djaenicke/oscar_design/matlab/fxos_calibration/motionCalresults.JPG

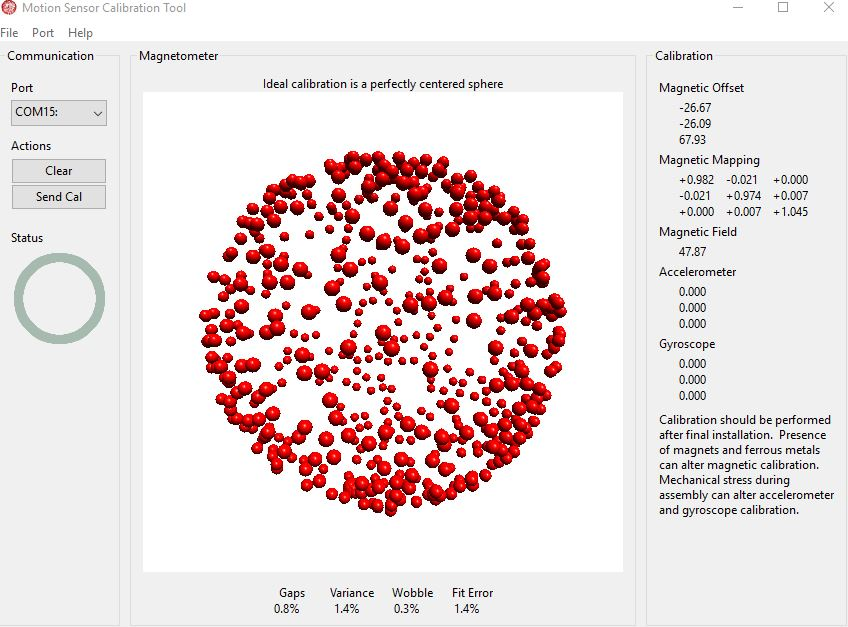
matlab/fxos_calibration/motionCalresults.JPG
