djaenicke/oscar_design/README.md

# robo_car
Robot car platform used for developing autonomous vehicle concepts
