djaenicke/oscar_design/(list of files, cad)

Other CAD files:
mechanical/v2/assembly_v2.dwg
mechanical/v2/OldVersions/assembly_v2.0004.dwg
mechanical/assembly_v2.iam
mechanical/battery_pack_clamp_v2.ipt
mechanical/bp_v3.ipt
mechanical/gearmotor.ipt
mechanical/main_motor_mount.ipt
mechanical/mock_wheel.ipt
mechanical/motor_support_v2.ipt
mechanical/rplidar_adapter_board_holder.ipt
mechanical/tenergy_nimh_2200.ipt
mechanical/tp_v2.ipt
mechanical/v1/base_plate_bottom.ipt
mechanical/v1/base_plate_no_holes.ipt
mechanical/v2/anker_battery_pack.ipt
mechanical/v2/assembly.iam
mechanical/v2/battery_pack_clamp.ipt
mechanical/v2/boost_converter.ipt
mechanical/v2/bp_v2.ipt
mechanical/v2/gearmotor.ipt
mechanical/v2/mock_wheel.ipt
mechanical/v2/motor_support.ipt
mechanical/v2/tp_v2.ipt
mechanical/v2/wheel_axle.ipt
