djaenicke/oscar_design/electrical/oscar_shield.pdf

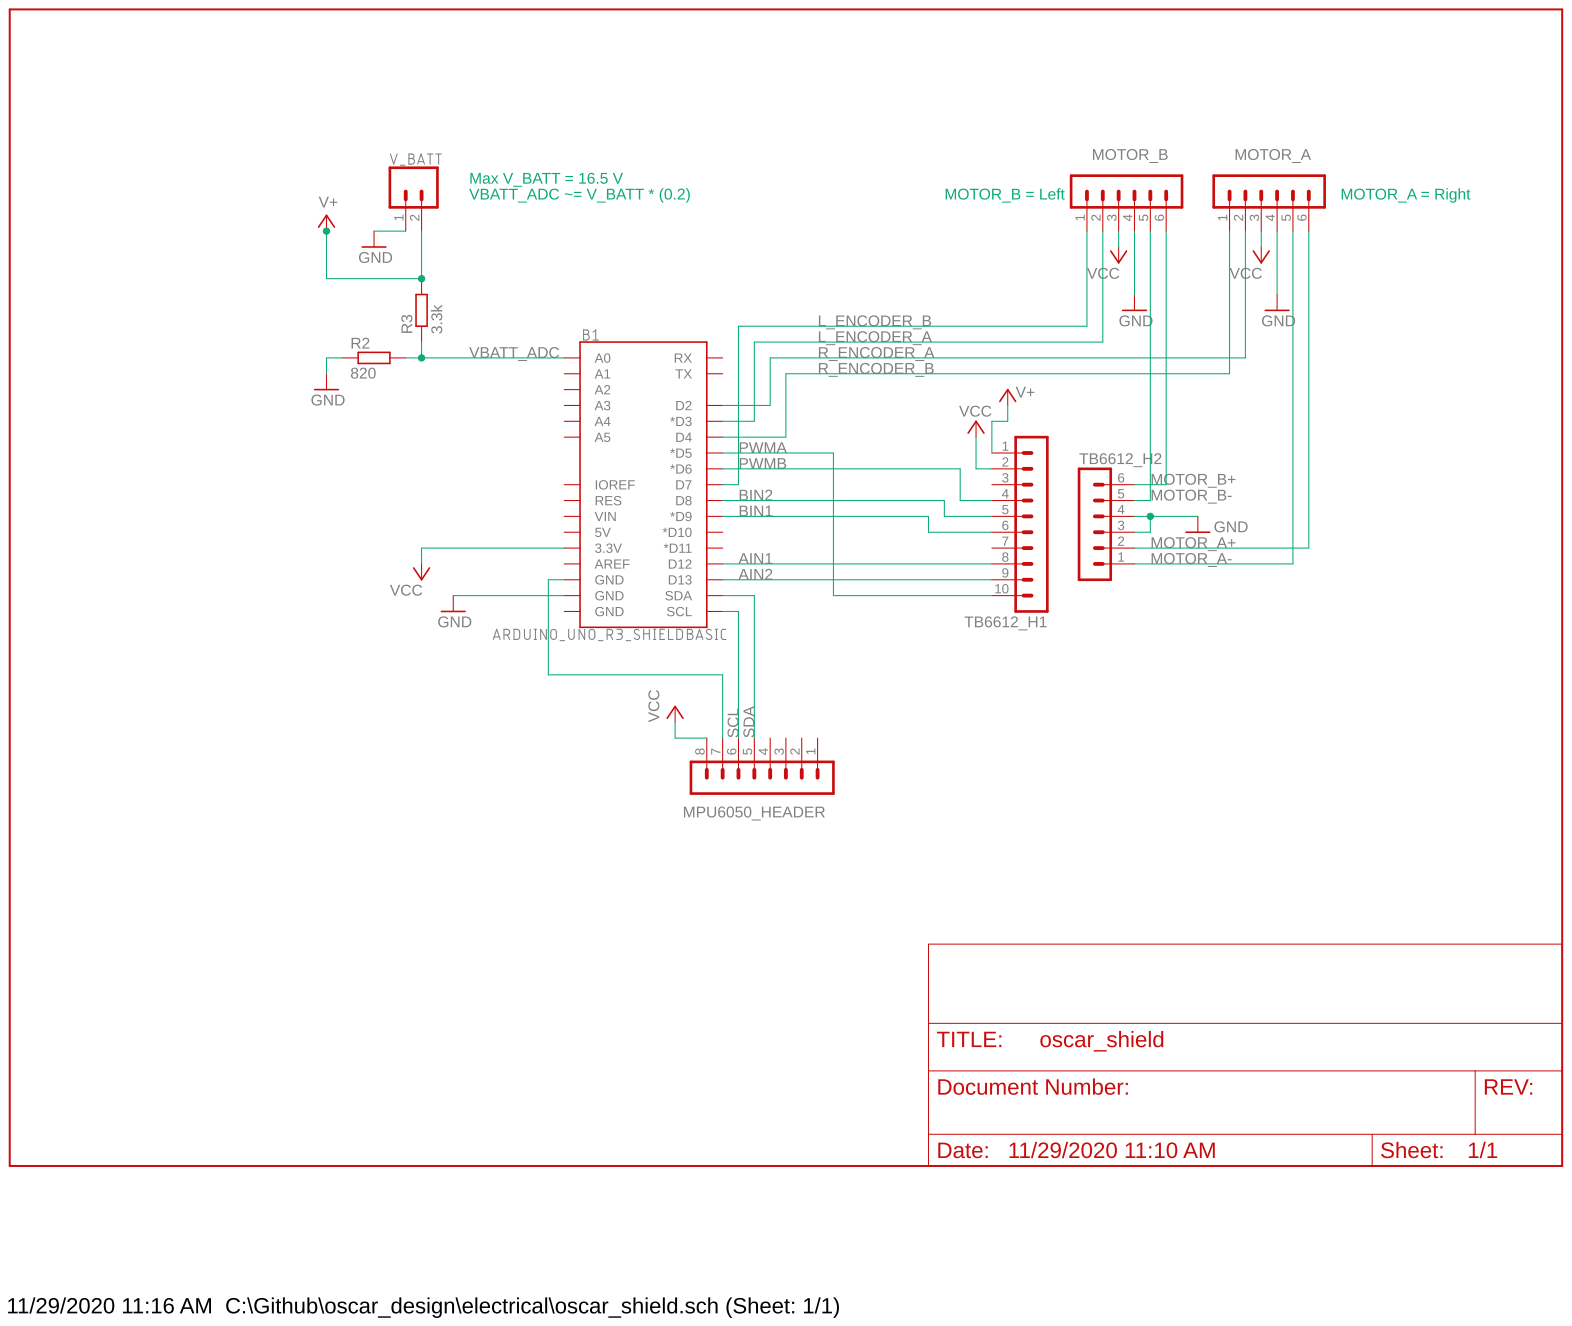
[picture p2: page 1]
