djaenicke/oscar_design/electrical/v1/robo_shield.brd

## EAGLE design electrical/v1/robo_shield.brd (2020-05-10)

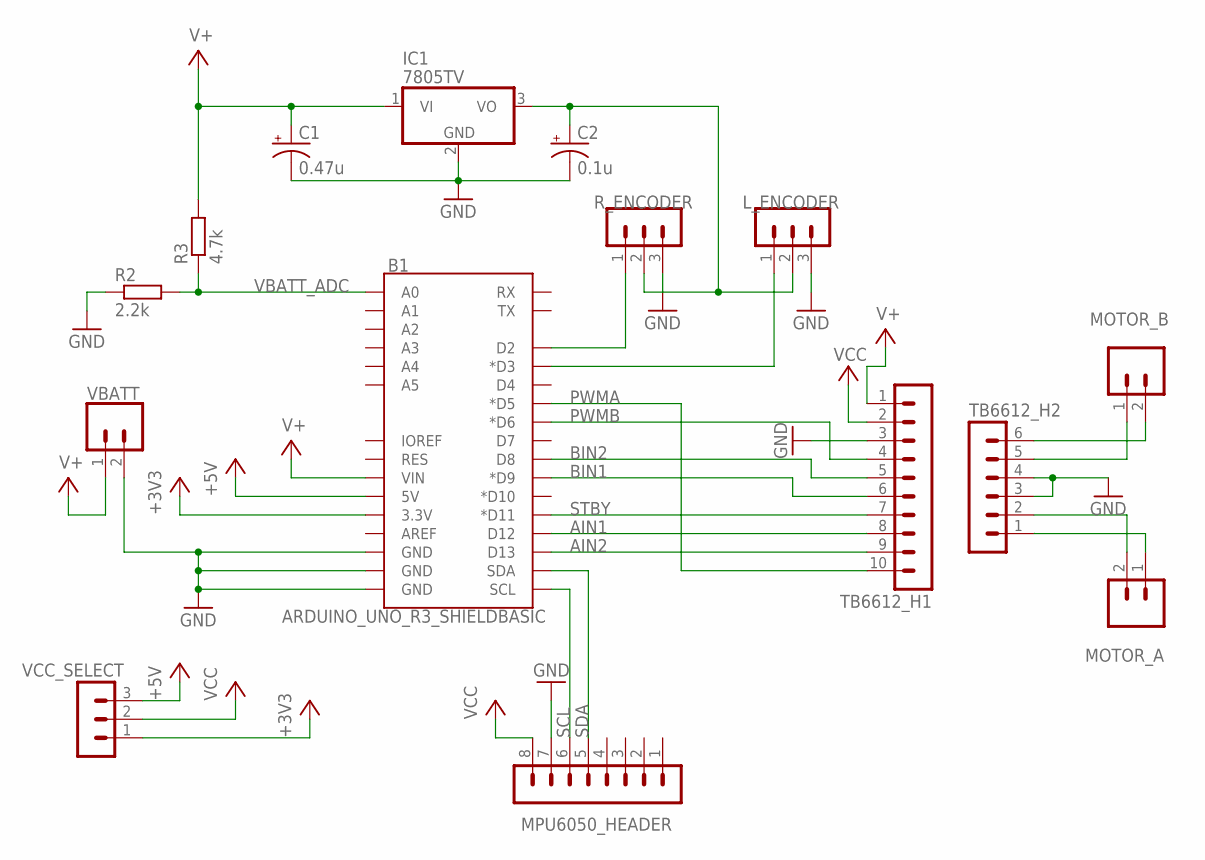
[picture p3: schematic robo_shield.sch]

Parts:
B1: ARDUINO_UNO_R3_SHIELDBASIC; UNO_R3_SHIELD
C1: 0.47u; E5-5
C2: 0.1u; E5-5
IC1: 7805TV; TO220V
L_ENCODER: MA03-1
MOTOR_A: CONN_025MM; SCREWTERMINAL-5MM-2
MOTOR_B: CONN_025MM; SCREWTERMINAL-5MM-2
MPU6050_HEADER: MA08-1
R2: 2.2k; 0207/10
R3: 4.7k; 0207/10
R_ENCODER: MA03-1
TB6612_H1: MA10-1
TB6612_H2: MA06-1
VBATT: CONN_025MM; SCREWTERMINAL-5MM-2
VCC_SELECT: MA03-1

Connections:
+3V3: B1.3.3V, VCC_SELECT.1
+5V: B1.5V, VCC_SELECT.3
AIN1: B1.D12, TB6612_H1.8
AIN2: B1.D13, TB6612_H1.9
BIN1: B1.D9 (*D9), TB6612_H1.6
BIN2: B1.D8, TB6612_H1.5
GND: B1.GND@0 (GND), B1.GND@1 (GND), B1.GND@2 (GND), C1.-, C2.-, IC1.2 (GND), L_ENCODER.3, MPU6050_HEADER.7, R2.1, R_ENCODER.3, TB6612_H1.3, TB6612_H2.3, TB6612_H2.4, VBATT.2
unnamed: B1.D2, R_ENCODER.1
unnamed: B1.D3 (*D3), L_ENCODER.1
unnamed: MOTOR_B.2, TB6612_H2.6
unnamed: MOTOR_B.1, TB6612_H2.5
unnamed: MOTOR_A.2, TB6612_H2.2
unnamed: MOTOR_A.1, TB6612_H2.1
unnamed: C2.+, IC1.3 (VO), L_ENCODER.2, R_ENCODER.2
PWMA: B1.D5 (*D5), TB6612_H1.10
PWMB: B1.D6 (*D6), TB6612_H1.4
SCL: B1.SCL, MPU6050_HEADER.6
SDA: B1.SDA, MPU6050_HEADER.5
STBY: B1.D11 (*D11), TB6612_H1.7
V+: B1.VIN, C1.+, IC1.1 (VI), R3.2, TB6612_H1.1, VBATT.1
VBATT_ADC: B1.A0, R2.2, R3.1
VCC: MPU6050_HEADER.8, TB6612_H1.2, VCC_SELECT.2

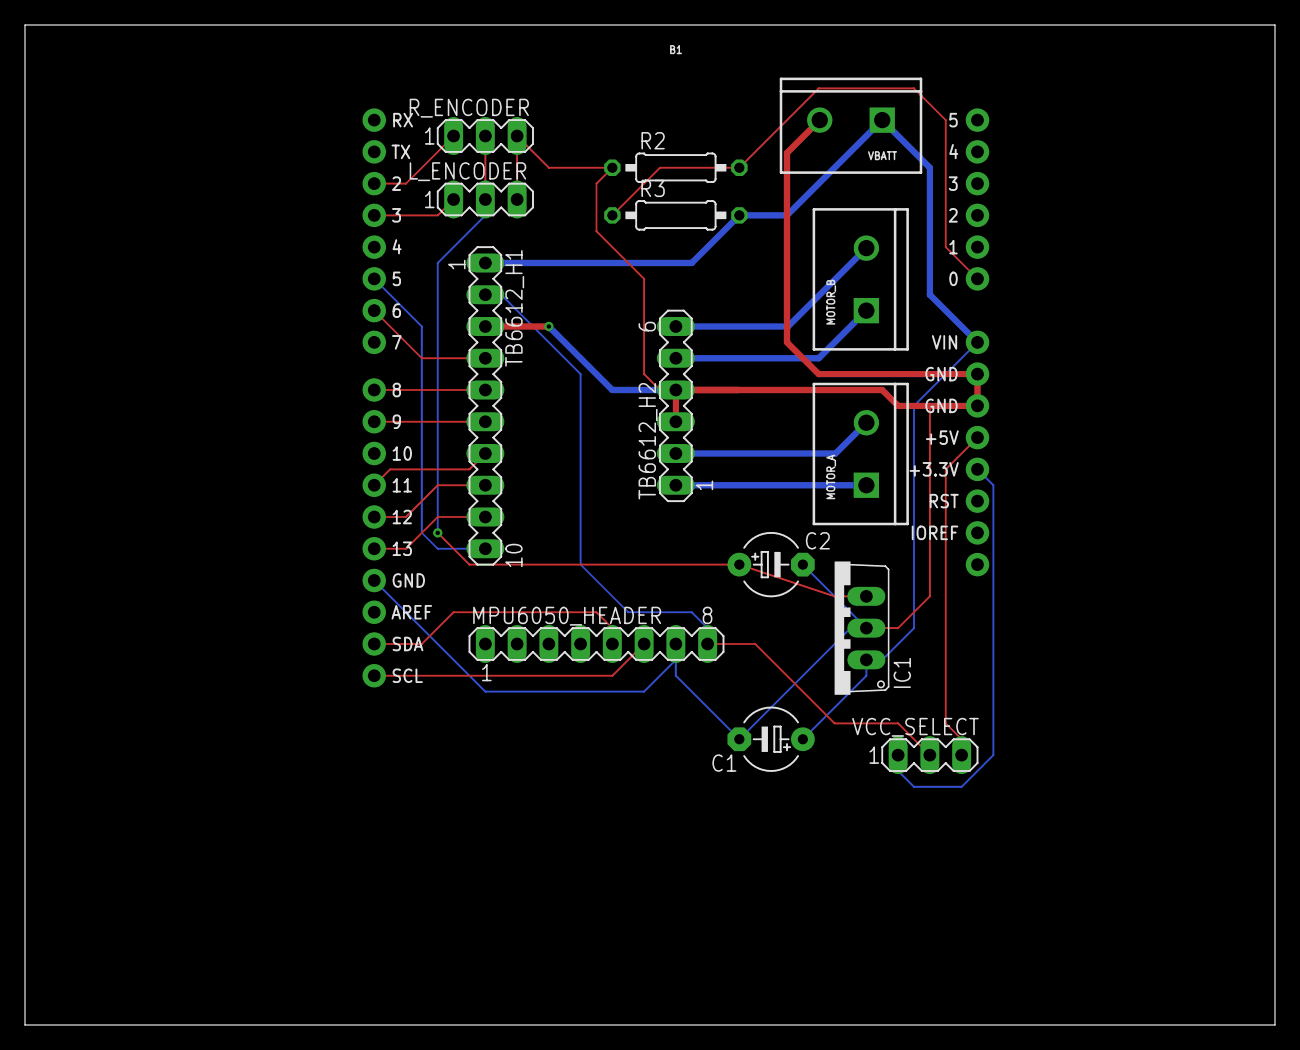
[picture p4: board robo_shield.brd from above]

Board: 2 copper layers, 100.0 x 80.0 mm, 15 parts (0 on the bottom side), 22 nets.
