djaenicke/oscar_design/matlab/fxos_calibration/fxos_ss_data.xlsx

ax | ay | az | ax sigma^2 | ay sigma^2 | az sigma^2
0.00719 | 0.00479 | 9.82437 | 2.717815775e-05 | 4.625843339e-05 | 5.244364491e-05
0.0024 | 0.00479 | 9.82677
0.0024 | 0.00958 | 9.84114
-0.00479 | 0.0024 | 9.82677
0 | 0.00479 | 9.82437
0.00479 | -0.00719 | 9.81958
0.00479 | -0.0024 | 9.82677
0.0024 | 0.00479 | 9.81719
-0.00958 | 0.01677 | 9.8124
0 | 0.01198 | 9.81479
0 | 0.01677 | 9.82677
0.00719 | -0.00479 | 9.8124
0 | -0.00958 | 9.82437
-0.0024 | 0.00479 | 9.81958
0.0024 | -0.0024 | 9.82916
0.00719 | 0 | 9.82198
-0.00479 | 0.0024 | 9.82198
0 | -0.00479 | 9.81719
-0.00479 | -0.0024 | 9.81479
0.01198 | 0.00958 | 9.83395
0 | 0 | 9.82198
0.00479 | 0.00958 | 9.83874
0 | 0 | 9.82916
0 | -0.00479 | 9.81719
0.00479 | 0.00719 | 9.82198
0.01198 | -0.00479 | 9.81
0 | 0.0024 | 9.82437
0.0024 | 0.0024 | 9.83395
0 | 0.00479 | 9.81958
-0.00958 | 0 | 9.82677
0.00479 | 0.00479 | 9.82198
-0.0024 | 0.01198 | 9.81479
0.00958 | 0 | 9.81719
-0.00479 | 0.0024 | 9.81958
0.00719 | -0.01198 | 9.81958
-0.0024 | 0.01437 | 9.81479
0.00479 | 0 | 9.81479
-0.00479 | -0.00958 | 9.82916
0.0024 | 0.00958 | 9.81958
0.0024 | 0 | 9.82198
0.00479 | 0.01198 | 9.81719
-0.00719 | -0.01198 | 9.82677
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
