djaenicke/oscar_design/matlab/mpu_calibration/mpu_accel_ss_data.xlsx

ax | ay | az | ax sigma^2 | ay sigma^2 | az sigma^2
-0.05868 | 0.02635 | 9.79803 | 0.000191915692 | 0.0002072919279 | 0.0003625467252
-0.03593 | 0.03712 | 9.82796
-0.05748 | 0.04551 | 9.80521
-0.05628 | 0.05748 | 9.83395
-0.06107 | 0.06227 | 9.82078
-0.04431 | 0.06706 | 9.78366
-0.04551 | 0.05389 | 9.80042
-0.05748 | 0.02275 | 9.82677
-0.04431 | 0.02515 | 9.79084
-0.04311 | 0.03473 | 9.78725
-0.07664 | 0.01437 | 9.77168
-0.03832 | 0.03952 | 9.82796
-0.04191 | 0.04191 | 9.78725
-0.02754 | 0.02635 | 9.78126
-0.05628 | 0.07065 | 9.81838
-0.06347 | 0.05389 | 9.78725
-0.03593 | 0.05628 | 9.78605
-0.06347 | 0.05389 | 9.80641
-0.06347 | 0.0479 | 9.81838
-0.05988 | 0.02515 | 9.80042
-0.03353 | 0.03712 | 9.82198
-0.04551 | 0.03473 | 9.82557
-0.04311 | 0.02754 | 9.81599
-0.04551 | 0.06706 | 9.83515
-0.04072 | 0.06706 | 9.81838
-0.04311 | 0.03832 | 9.81599
-0.06347 | 0.00719 | 9.82677
-0.05509 | 0.04072 | 9.80401
-0.05509 | 0.07065 | 9.80521
-0.03952 | 0.03473 | 9.82677
-0.05509 | 0.02395 | 9.82078
-0.06826 | 0.07904 | 9.76689
-0.06227 | 0.03473 | 9.80641
-0.05149 | 0.03114 | 9.8124
-0.03114 | 0.05988 | 9.82916
-0.05509 | 0.03712 | 9.78725
-0.05748 | 0.01916 | 9.81359
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
