djaenicke/oscar_design/matlab/mpu_calibration/mpu_gyro_ss_data.xlsx

gx | gy | gz | gx sigma^2 | gy sigma^2 | gz sigma^2
-0.00053 | 0.00053 | -0.0008 | 9.995696717e-07 | 6.520316624e-06 | 2.956457156e-05
-0.00053 | 0.00093 | 0.0004
0.00027 | 0.00013 | -0.00133
-0.0004 | 0.00053 | -0.00093
-0.00146 | -0.00013 | -0.00053
-0.00133 | 0.0004 | -0.00067
-0.00053 | -0.00027 | -0.00027
-0.00133 | -0.00013 | -0.00067
-0.00067 | 0.00013 | -0.00093
-0.00133 | 0.0012 | 0.00013
0 | 0.00013 | -0.0012
-0.00146 | 0.00053 | -0.00013
-0.00067 | 0.00053 | 0.0004
-0.0004 | 0.00027 | -0.00067
0 | -0.00013 | -0.0012
-0.00053 | 0.00067 | -0.0004
-0.00067 | -0.00013 | 0.00107
-0.0004 | -0.00013 | 0.00013
-0.0016 | 0.00067 | 0.00053
-0.0004 | -0.00013 | -0.0004
-0.00053 | 0.0012 | -0.00053
-0.00027 | 0.00107 | 0.0004
-0.0008 | 0.00053 | -0.0012
0.0004 | 0.00053 | -0.00053
-0.0004 | -0.0008 | -0.00067
-0.00186 | 0.00133 | -0.00027
-0.0008 | 0.00013 | 0
-0.00107 | 0.0004 | 0.00013
-0.00053 | 0.0008 | 0.00053
0.00013 | 0.00053 | -0.00013
-0.0008 | 0.0004 | -0.00013
-0.00133 | 0.00133 | -0.0008
-0.00186 | 0.00027 | -0.00013
-0.0016 | 0 | 0.0004
-0.00107 | 0.00107 | -0.00013
0.00013 | 0.0008 | 0
-0.00107 | 0.0008 | 0.0004
-0.00173 | 0.00053 | -0.0004
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
