djaenicke/oscar_design/car_controller/source/car_controller.cpp

/*
 * Copyright 2016-2018 NXP
 * All rights reserved.
 *
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
 * o Neither the name of NXP Semiconductor, Inc. nor the names of its
 *   contributors may be used to endorse or promote products derived from this
 *   software without specific prior written permission.
 *
 * THIS SOFTWARE IS PROVIDED BY THE COPYRIGHT HOLDERS AND CONTRIBUTORS "AS IS" AND
 * ANY EXPRESS OR IMPLIED WARRANTIES, INCLUDING, BUT NOT LIMITED TO, THE IMPLIED
 * WARRANTIES OF MERCHANTABILITY AND FITNESS FOR A PARTICULAR PURPOSE ARE
 * DISCLAIMED. IN NO EVENT SHALL THE COPYRIGHT HOLDER OR CONTRIBUTORS BE LIABLE FOR
 * ANY DIRECT, INDIRECT, INCIDENTAL, SPECIAL, EXEMPLARY, OR CONSEQUENTIAL DAMAGES
 * (INCLUDING, BUT NOT LIMITED TO, PROCUREMENT OF SUBSTITUTE GOODS OR SERVICES;
 * LOSS OF USE, DATA, OR PROFITS; OR BUSINESS INTERRUPTION) HOWEVER CAUSED AND ON
 * ANY THEORY OF LIABILITY, WHETHER IN CONTRACT, STRICT LIABILITY, OR TORT
 * (INCLUDING NEGLIGENCE OR OTHERWISE) ARISING IN ANY WAY OUT OF THE USE OF THIS
 * SOFTWARE, EVEN IF ADVISED OF THE POSSIBILITY OF SUCH DAMAGE.
 */
 
/**
 * @file    car_controller.cpp
 * @brief   Application entry point.
 */
#include <stdio.h>

/* SDK includes */
#include "board.h"
#include "peripherals.h"
#include "pin_mux.h"
#include "clock_config.h"
#include "MK64F12.h"
#include "fsl_debug_console.h"
#include "fsl_sysmpu.h"

/* FreeRTOS kernel includes. */
#include "FreeRTOS.h"
#include "task.h"
#include "queue.h"
#include "timers.h"

/* Application */
#include "data_logger.h"
#include "inertial_states.h"
#include "car_controller.h"
#include "io_abstraction.h"
#include "motor_controls.h"
#include "servo.h"
#include "wheel_speeds.h"
#include "bluetooth_control.h"
#include "battery_monitor.h"
#include "interrupt_prios.h"
#include "logging_streams.h"
#include "object_detection.h"

/*******************************************************************************
 * Definitions
 ******************************************************************************/
#define SD_CARD_INIT_TASK_PRIO     (configMAX_PRIORITIES - 1U)
#define MC_DATA_LOGGING_TASK_PRIO  (configMAX_PRIORITIES - 2U)
#define MOTOR_CONTROLS_TASK_PRIO   (configMAX_PRIORITIES - 3U)
#define OBJECT_DETECTION_TASK_PRIO (configMAX_PRIORITIES - 4U)
#define BLUETOOTH_CMD_TASK_PRIO    (configMAX_PRIORITIES - 5U)

typedef struct Task_Cfg_Tag
{
    TaskFunction_t func;
    const char name[configMAX_TASK_NAME_LEN];
    const configSTACK_DEPTH_TYPE stack_size;
    UBaseType_t priority;
    TaskHandle_t handle;
} Task_Cfg_T;

static void Init_App(void);

/*******************************************************************************
* Variables
******************************************************************************/


/*******************************************************************************
 * Function Definitions
 ******************************************************************************/
int main(void)
{
   /* Init board hardware. */
   BOARD_InitBootPins();
   BOARD_InitBootClocks();
   BOARD_InitBootPeripherals();

   /* Init FSL debug console. */
   BOARD_InitDebugConsole();
   NVIC_SetPriority(BOARD_SDHC_IRQ, SDHC_INT_PRIO);
   SYSMPU_Enable(SYSMPU, false);

   Init_App();
   Set_GPIO(BLUE_LED, LOW);

   /* Create OS Tasks */
   xTaskCreate(Motor_Controls_Task,  "Motor_Controls",    1024, NULL, MOTOR_CONTROLS_TASK_PRIO,   NULL);
   xTaskCreate(Bluetooth_Cmd_Task,   "Bluetooth_Control", 1024, NULL, BLUETOOTH_CMD_TASK_PRIO,    NULL);
   xTaskCreate(SD_Card_Init_Task,    "SD_Card_Init_Task", 1024, NULL, SD_CARD_INIT_TASK_PRIO,     NULL);
   xTaskCreate(Log_MC_Stream_Task,   "MC_Logging_Task",   1024, NULL, MC_DATA_LOGGING_TASK_PRIO,  NULL);
   xTaskCreate(Object_Detection_Task,"Obj_Det_Task",      1024, NULL, OBJECT_DETECTION_TASK_PRIO, NULL);

   vTaskStartScheduler();
}

void Init_App(void)
{
   Init_Battery_Monitor();
   Init_Inertial_Sensors();
   Init_Wheel_Speed_Sensors();
   Init_Motor_Controls();
   Init_Object_Detection();
   Bluetooth_Serial_Open();
   Create_Streams();

   NVIC_SetPriorityGrouping(0U);
}
