djaenicke/oscar_design/(commit log)

2019-06-07 Updated core clock to 120 MHz
    Also, the default board files were replaced with empty files.
    [car_controller.cpp]
2019-06-08 Updates to get the motors working (no speed control yet)
2019-06-08 Added the ability to control the motor speed via PWM
2019-06-09 Added a class for controlling the object sensor servo
2019-06-11 Added a battery monitor to measure the battery voltage
2019-06-14 Added wheel speed sensors
2019-06-19 Fixed bug with rr wheel speed getting corrupted
    [logging.cpp]
2019-06-20 Moved to period based encoder measurement
    There are no issues with 0 rad/s readings when the data logging is disabled. When it's enabled, there are issues with the readings.
    [logging.cpp]
2019-06-20 Added a simple filter to the wheel speed calculation
2019-06-21 Wheel speeds are decent at 25ms sample rate...
2019-06-23 Simplified the wheel speed measurements
2019-06-23 Added a simple low pass filter
2019-06-25 Added a PID class
2019-06-28 Moved the wheel speed filtering out of the interrupt
2019-06-30 Wheel speeds measurements are good
2019-06-30 Reworked the data logging
    [car_controller.cpp]
2019-06-30 Implemented the PID controllers
    PID controller is working well under no-load conditions
2019-06-30 More PID controller changes...
    PID is still not working very well
2019-07-02 Removed the two front wheel speed sensors
    The two right and two left motors cannot be controlled independently
2019-07-03 PID is working!
2019-07-04 Updated Servo class to use more encapsulation
2019-07-04 Added initial ultrasonic sensor code
2019-07-04 Updated servo class to work with any FTM
    This isn't quite done yet. Need a way to redirect the ISRs
2019-07-04 Servo class can now be instaniated multiple times
2019-07-04 UltrasonicSensor now supports multiple instantiation
2019-07-05 Added comments in Servo and UltrasonicSensor classes
2019-07-06 Ultrasonic sensor is working
2019-07-07 Added IMU initialization code
2019-07-13 Added MPU6050 class
    - Need to add a delay based on the FTM
    - Need to allow the I2C channel to be configurable
2019-07-13 Added MPU6050 object for more inertial measurements to IMU.cpp
2019-07-14 Added gyro readings from MPU6050
2019-07-20 Added filtering to battery measurement
2019-07-20 Created a separate class for the onboard 6-axis sensor
2019-07-27 Flipped the direction for the new motors
2019-07-27 Switched the speed controller to use the hall effect speed sensors
2019-07-28 Switched hall effect sensors to use period measurement
2019-07-28 Missed from previous commit
    [car_controller.cpp]
2019-07-28 Switched the debug console from semihosting to UART
2019-07-28 Retuned based on system identification
    [open_loop_matlab.csv]
2019-07-28 Moved wheel speed measurements to inertial_states.cpp
2019-11-10 Added data
    [closed_loop_no_filter.csv, open_loop_matlab.csv, open_loop_no_filter.csv]
2019-11-10 Removed optical encoder measurements
    Closed loop is still functional
2019-11-10 Updated data
    [closed_loop_no_filter.csv, open_loop_no_filter.csv]
2019-11-29 Added a new simulation with both motors
2019-11-29 Collected more data
    [closed_loop_no_filter.csv, open_loop_no_filters_ss.csv]
2019-11-29 Added the wheel speed filters into the simulation
2019-11-30 Added MATLAB scripts for FFT based method for measuring wheel speeds
2019-12-01 N=1024 seems to be the sweet spot
    N=1024 provides a good tradeoff between execution time and wheel speed measurement accuracy.
2019-12-01 Created new module to run the wheel speed FFTs
2019-12-01 Wheel speed measureme nt via FFT method is working.
    [closed_loop_w_fft_and_filters.csv]
2019-12-04 Updated matlab scripts for data analysis
    [cl_period_meas_w_filters.csv, cl_w_fft_w_filters.csv, closed_loop_w_fft_and_filters.csv, open_loop_matlab.csv, open_loop_no_filter.csv, open_loop_no_filters_ss.csv]
2019-12-15 Initial steps for developing Kalman filters
2019-12-23 removed fft wheel speed measurements
2019-12-29 Added imu and odometry messages
2020-01-01 Added accel bias compensation to FX0S sensor
2020-01-04 Added software based acceleration bias compensation for the FXOS sensor
2020-03-31 modeling updates
    [4p5v_open_loop.csv, 4v_open_loop.csv, 5p5v_open_loop.csv, 5p75v_open_loop.csv, 5v_open_loop.csv, 6v_open_loop.csv, data.csv, motor_constants.xlsx]
2020-05-10 Deleting unused scripts
    [cl_period_meas_w_filters.csv, cl_w_fft_w_filters.csv, data.csv]
2020-05-10 Added shield schematic/pcb and mechanical part drawings
    [base_plate_bottom.ipt, base_plate_no_holes.ipt, robo_car_shield.xlsx, robo_shield.brd, robo_shield.sch]
2020-05-19 Added sensor characterization data
    [fxos_mag_cal_data1.csv, fxos_mag_cal_data2.csv, fxos_mag_cal_data3.csv, fxos_ss_data.xlsx, mpu_accel_ss_data.xlsx, mpu_gyro_ss_data.xlsx]
2020-06-21 Adding new parts for v2 of the platform
    [main_motor_mount.ipt, motor_support.ipt, wheel_axle.ipt]
2020-11-29 Added v3 mechanical design
    [anker_battery_pack.ipt, assembly.iam, assembly_v2.0004.dwg, assembly_v2.dwg, assembly_v2.iam, base_plate_bottom.ipt, base_plate_no_holes.ipt, battery_pack_clamp.ipt]
2020-11-29 Updated schematic and board layout
    [oscar_shield.brd, oscar_shield.sch, oscar_shield.xlsx, robo_car_shield.xlsx, robo_shield.brd, robo_shield.sch]
